OLIMEX/RP2350pc/(threads)

Thread 2 (2025-07-01):

Audio codec is "MONO", not "Stereo"

ericfont, 2025-07-01:
The [product page](https://www.olimex.com/Products/RaspberryPi/PICO/RP2350pc/open-source-hardware) and [readme](https://github.com/OLIMEX/RP2350pc/blob/main/README.md) incorrectly says "Stereo Audio codec", but the schematic has ES8311, which is a mono in and mono out codec chip. Although the codec has differential output, and although the output plus goes to the left headphone and amp while the output minus goes to the right headphone and amp, the left and right outputs would simply be the same audio signal of opposite polarities, so that output still is technically just "MONO", not "Stereo"!  Please correct the product page and readme's description.
