OLIMEX/RP2350pc/HARDWARE/RP2350pc-Rev.A/RP2350pc_Rev_A.kicad_sch

## KiCad design HARDWARE/RP2350pc-Rev.A/RP2350pc_Rev_A.kicad_sch (2025-06-16)

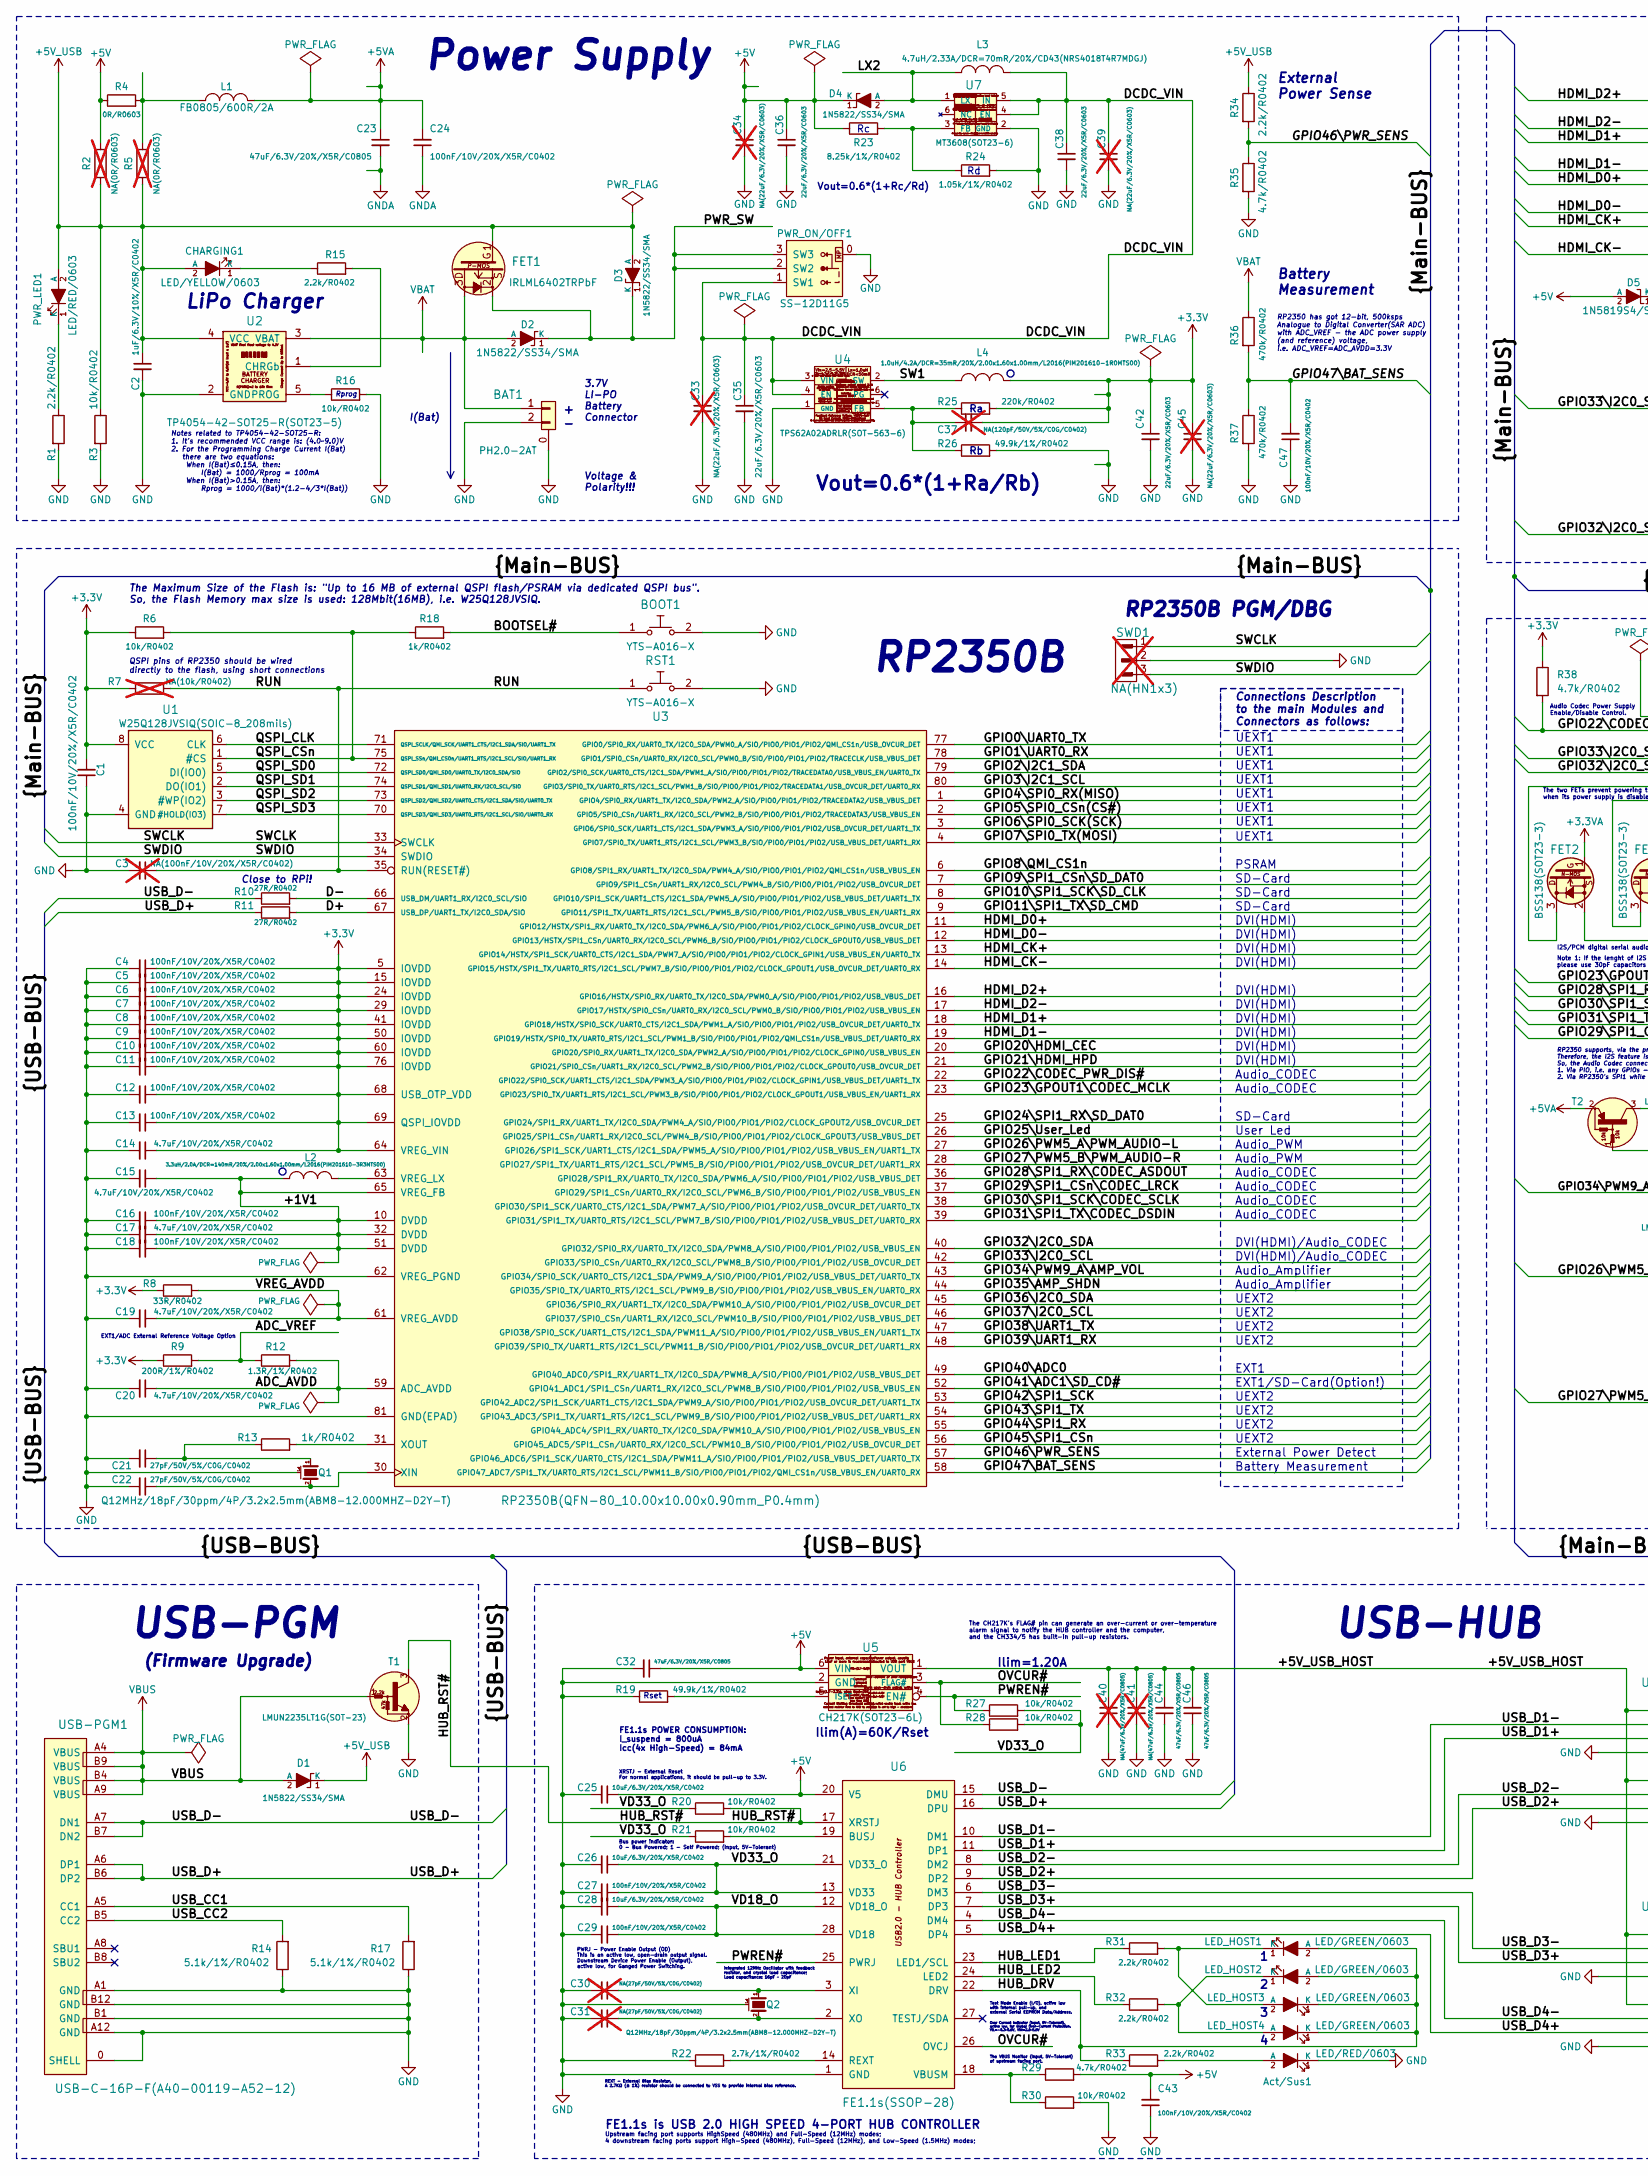
[picture p2: schematic RP2350pc_Rev_A.kicad_sch, part in row 1, column 1]

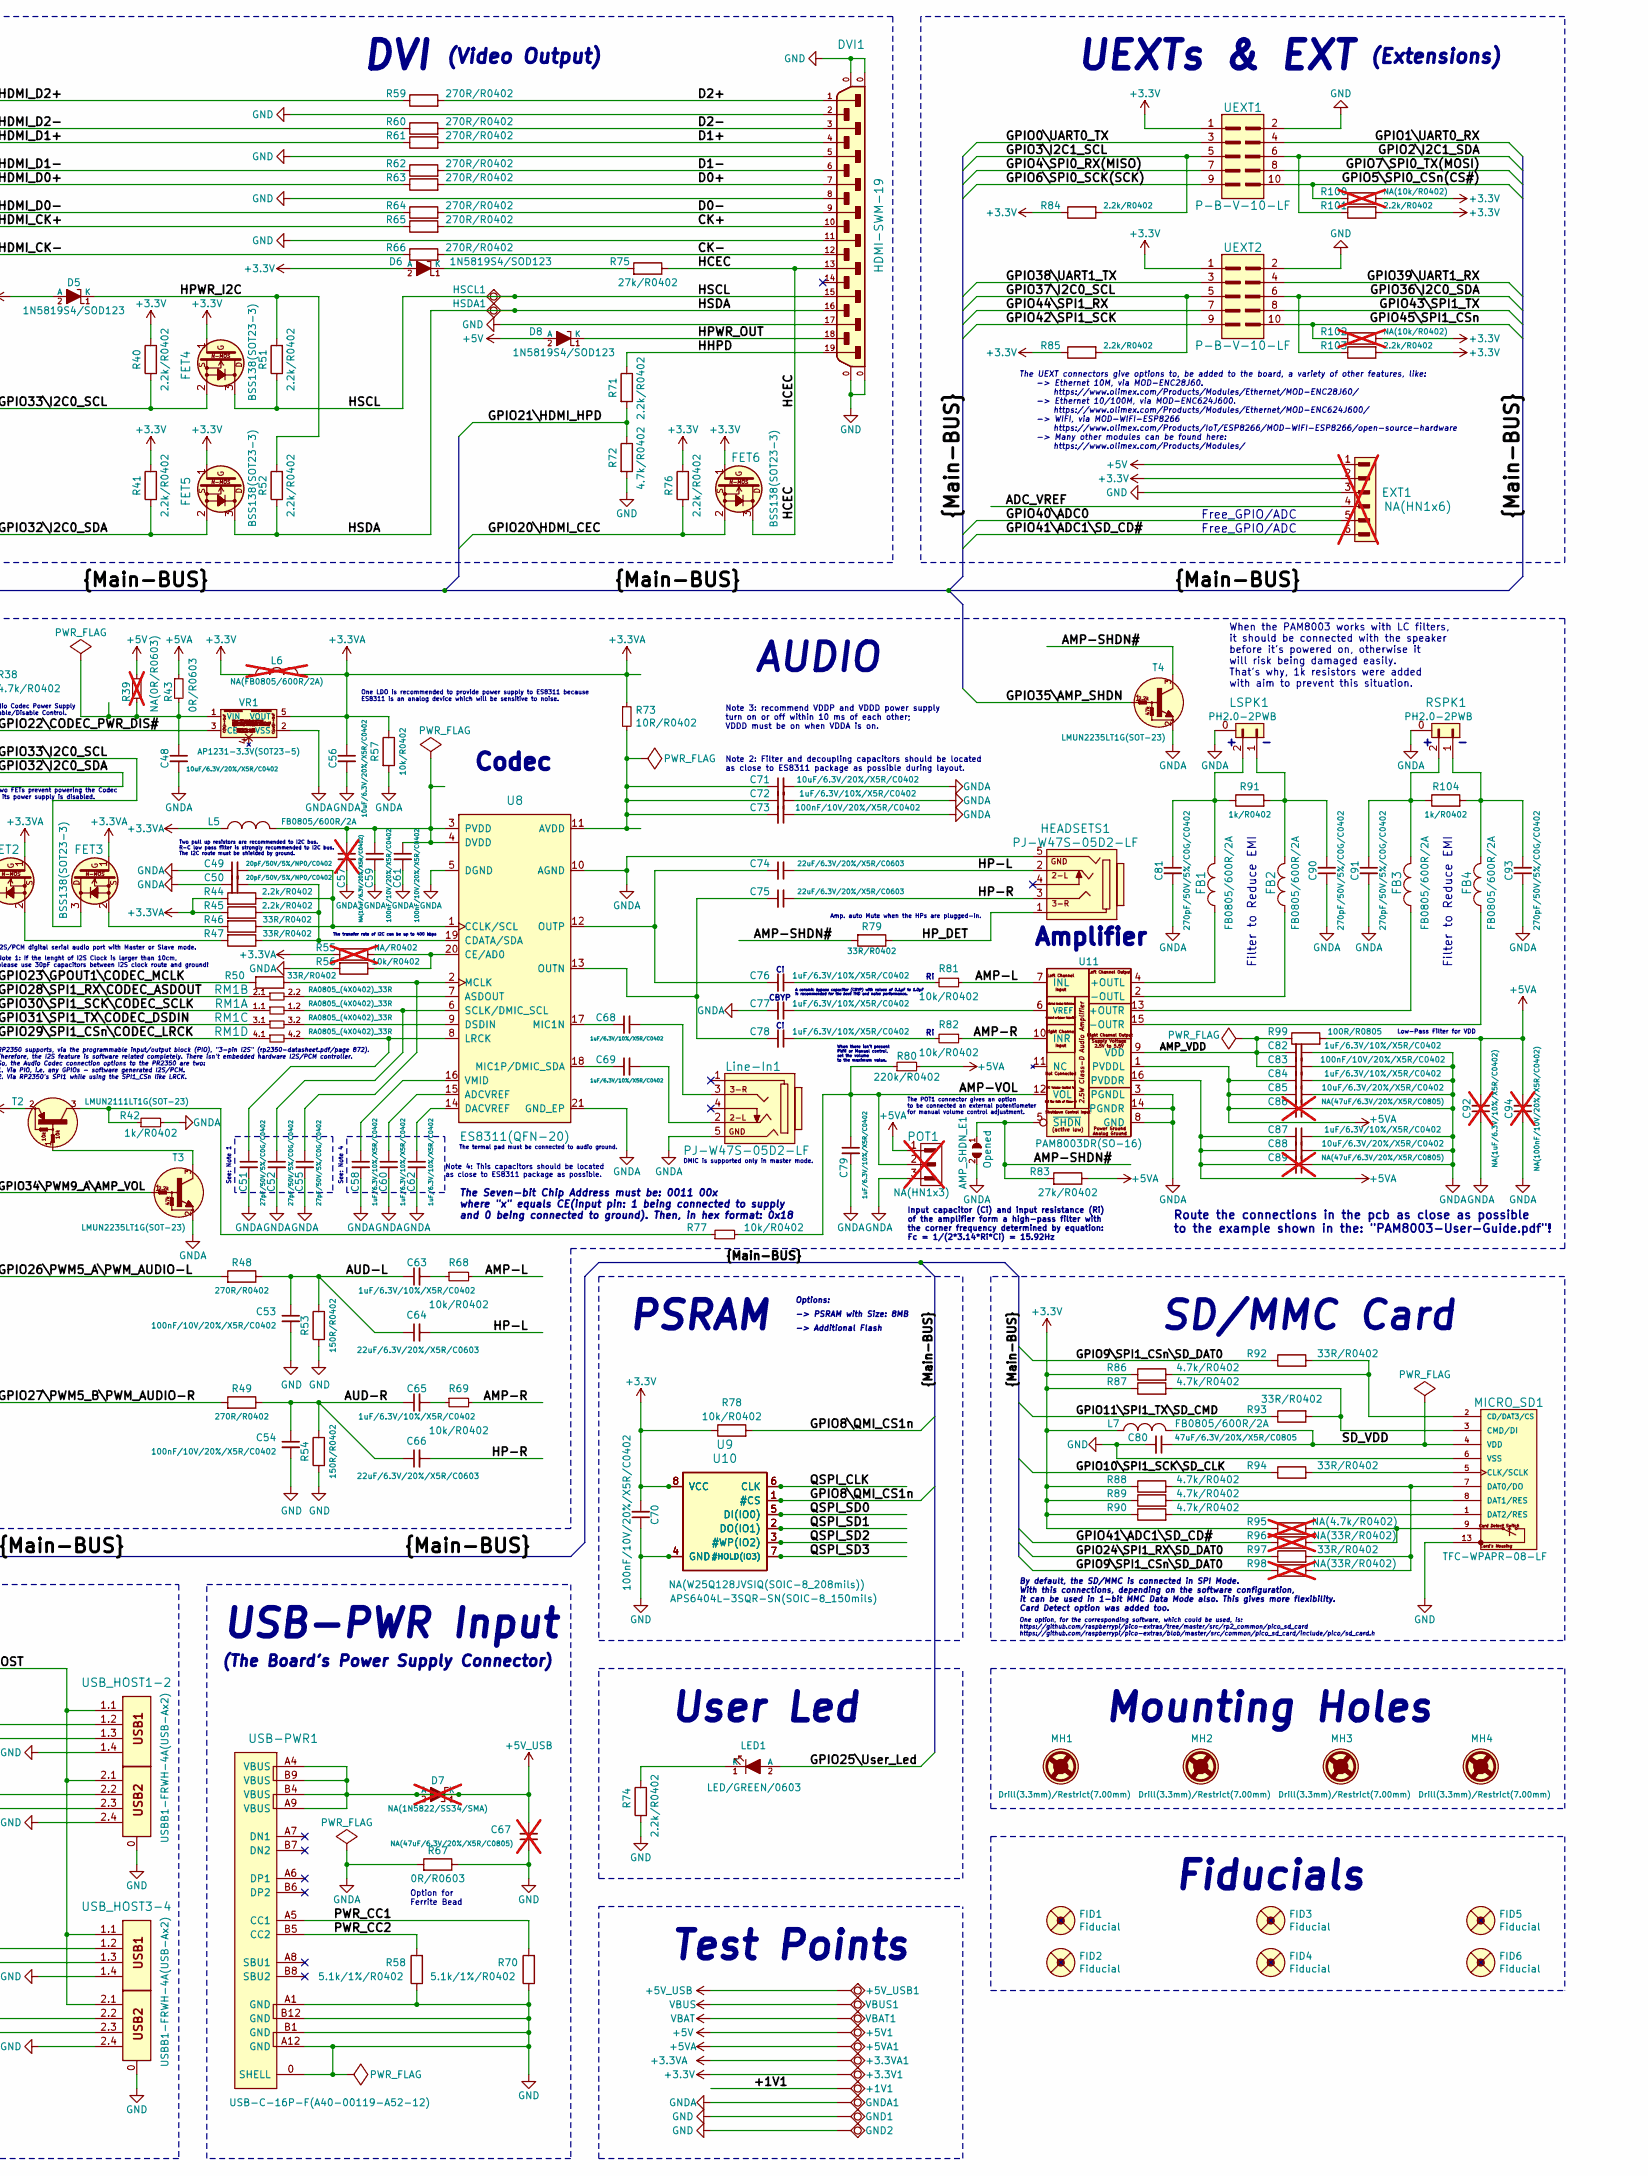
[picture p3: schematic RP2350pc_Rev_A.kicad_sch, part in row 1, column 2]

Parts:
+1V1, +3.3V1, +3.3VA1, +5V1, +5VA1, +5V_USB1: TESTPAD; TESTPAD_40-ROUND
AMP_SHDN_E1: Opened; SJ
Act/Sus1: LED/RED/0603; LED_0603_KA
BAT1: PH2.0-2AT; PH2.0-2AT(BAT)
BOOT1: YTS-A016-X
C1, C4, C5, C6, C7, C8, C9, C10, C11, C12, C13, C16, C18, C24, C27, C29, C43, C47, C53, C54, C59, C61, C70, C73, C83: 100nF/10V/20%/X5R/C0402; C_0402_5MIL_DWS
C2, C58, C60, C62, C63, C65, C68, C69, C72, C76, C77, C78, C79, C82, C84, C87: 1uF/6.3V/10%/X5R/C0402; C_0402_5MIL_DWS
C3, C94: NA(100nF/10V/20%/X5R/C0402); C_0402_5MIL_DWS; not fitted
C14, C15, C17, C19, C20: 4.7uF/10V/20%/X5R/C0402; C_0402_5MIL_DWS
C21, C22, C51, C52, C55: 27pF/50V/5%/C0G/C0402; C_0402_5MIL_DWS
C23, C32, C44, C46, C80: 47uF/6.3V/20%/X5R/C0805; C_0805_5MIL_DWS
C25, C26, C28, C48, C56, C71, C85, C88: 10uF/6.3V/20%/X5R/C0402; C_0402_5MIL_DWS
C30, C31: NA(27pF/50V/5%/C0G/C0402); C_0402_5MIL_DWS; not fitted
C33, C34, C39, C45: NA(22uF/6.3V/20%/X5R/C0603); C_0603_5MIL_DWS; not fitted
C35, C36, C38, C42, C64, C66, C74, C75: 22uF/6.3V/20%/X5R/C0603; C_0603_5MIL_DWS
C37: NA(120pF/50V/5%/C0G/C0402); C_0402_5MIL_DWS; not fitted
C40, C41, C67, C86, C89: NA(47uF/6.3V/20%/X5R/C0805); C_0805_5MIL_DWS; not fitted
C49, C50: 20pF/50V/5%/NP0/C0402; C_0402_5MIL_DWS
C57: NA(10uF/6.3V/20%/X5R/C0402); C_0402_5MIL_DWS; not fitted
C81, C90, C91, C93: 270pF/50V/5%/C0G/C0402; C_0402_5MIL_DWS
C92: NA(1uF/6.3V/10%/X5R/C0402); C_0402_5MIL_DWS; not fitted
CHARGING1: LED/YELLOW/0603; LED_0603_KA
D1, D2, D3, D4: 1N5822/SS34/SMA; SMA-KA
D5, D6, D8: 1N5819S4/SOD123; SOD-123_1C-2A_KA
D7: NA(1N5822/SS34/SMA); SMA-KA; not fitted
DVI1: HDMI-SWM-19; HDMI-SWM-19_Paste
EXT1: NA(HN1x6); HN1x6; not fitted
FB1, FB2, FB3, FB4: FB0805/600R/2A; L_0805_5MIL_DWS
FET1: IRLML6402TRPbF; SOT23
FET2, FET3, FET4, FET5, FET6: BSS138(SOT23-3); SOT23
FID1, FID2, FID3: Fiducial; Fiducial1x3_Paste
FID4, FID5, FID6: Fiducial; Fiducial1x3
GND1: TESTPAD; TEST_PAD40x70_SQUARE
GND2: TESTPAD; TESTPAD_40-ROUND
GNDA1: TESTPAD; TESTPAD_40-ROUND
HEADSETS1: PJ-W47S-05D2-LF; PJ-W47S-05D2-LF_5PIN_V2_LongerPads
HSCL1: TESTPAD; TESTPAD_40-ROUND
HSDA1: TESTPAD; TESTPAD_40-ROUND
L1, L5, L7: FB0805/600R/2A; L_0805_5MIL_DWS
L2: 3.3uH/2.0A/DCR=140mR/20%/2.00x1.60x1.00mm/L2016(P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; L_2016_MM
L3: 4.7uH/2.33A/DCR=70mR/20%/CD43(NRS4018T4R7MDGJ); CD42(43)
L4: 1.0uH/4.2A/DCR=35mR/20%/2.00x1.60x1.00mm/L2016(PI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; L_2016_MM
L6: NA(FB0805/600R/2A); L_0805_5MIL_DWS; not fitted
LED1: LED/GREEN/0603; LED_0603_KA
LED_HOST1, LED_HOST2, LED_HOST3, LED_HOST4: LED/GREEN/0603; LED_0603_KA
LSPK1: PH2.0-2PWB
Line-In1: PJ-W47S-05D2-LF; PJ-W47S-05D2-LF_5PIN_V2_LongerPads
MH1, MH2, MH3, MH4: Drill(3.3mm)/Restrict(7.00mm); Mounting_Hole_Drill-3.3mm_Clerance-7mm
MICRO_SD1: TFC-WPAPR-08-LF; TFC-WPAPR-08
POT1: NA(HN1x3); HN1x3; not fitted
PWR_LED1: LED/RED/0603; LED_0603_KA
PWR_ON/OFF1: SS-12D11G5
Q1, Q2: Q12MHz/18pF/30ppm/4P/3.2x2.5mm(ABM8-12.000MHZ-D2Y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; TSX-3.2x2.5mm_GND(3)
R1, R15, R31, R32, R33, R34, R40, R41, R44, R45, R51, R52, R71, R74, R76, R84, R85, R101, R103: 2.2k/R0402; R_0402_5MIL_DWS
R2, R5, R39: NA(0R/R0603); R_0603_5MIL_DWS; not fitted
R3, R6, R16, R20, R21, R27, R28, R30, R56, R57, R68, R69, R77, R78, R81, R82: 10k/R0402; R_0402_5MIL_DWS
R4, R43, R67: 0R/R0603; R_0603_5MIL_DWS
R7, R100, R102: NA(10k/R0402); R_0402_5MIL_DWS; not fitted
R8, R46, R47, R50, R79, R92, R93, R94, R97: 33R/R0402; R_0402_5MIL_DWS
R9: 200R/1%/R0402; R_0402_5MIL_DWS
R10, R11: 27R/R0402; R_0402_5MIL_DWS
R12: 1.3R/1%/R0402; R_0402_5MIL_DWS
R13, R18, R42, R91, R104: 1k/R0402; R_0402_5MIL_DWS
R14, R17, R58, R70: 5.1k/1%/R0402; R_0402_5MIL_DWS
R19, R26: 49.9k/1%/R0402; R_0402_5MIL_DWS
R22: 2.7k/1%/R0402; R_0402_5MIL_DWS
R23: 8.25k/1%/R0402; R_0402_5MIL_DWS
R24: 1.05k/1%/R0402; R_0402_5MIL_DWS
R25, R80: 220k/R0402; R_0402_5MIL_DWS
R29, R35, R38, R72, R86, R87, R88, R89, R90: 4.7k/R0402; R_0402_5MIL_DWS
R36, R37: 470k/R0402; R_0402_5MIL_DWS
R48, R49, R59, R60, R61, R62, R63, R64, R65, R66: 270R/R0402; R_0402_5MIL_DWS
R53, R54: 150R/R0402; R_0402_5MIL_DWS
R55: NA/R0402; R_0402_5MIL_DWS; not fitted
R73: 10R/R0402; R_0402_5MIL_DWS
R75, R83: 27k/R0402; R_0402_5MIL_DWS
R95: NA(4.7k/R0402); R_0402_5MIL_DWS; not fitted
R96, R98: NA(33R/R0402); R_0402_5MIL_DWS; not fitted
R99: 100R/R0805; R_0805_5MIL_DWS
RM1: RA0805_(4X0402)_33R; RA0805_(4X0402)_xx_BIGGEROUTPADS
RSPK1: PH2.0-2PWB
RST1: YTS-A016-X
SWD1: NA(HN1x3); HN1x3; not fitted
T1, T3, T4: LMUN2235LT1G(SOT-23); SOT23
T2: LMUN2111LT1G(SOT-23); SOT23
U1: W25Q128JVSIQ(SOIC-8_208mils); SO-8_208mil
U2: TP4054-42-SOT25-R(SOT23-5); SOT-23-5
U3: RP2350B(QFN-80_10.00x10.00x0.90mm_P0.4mm); QFN-80_10.00x10.00x0.90mm_P0.4mm
U4: TPS62A02ADRLR(SOT-563-6); SOT-563-6
U5: CH217K(SOT23-6L); SOT23-6
U6: FE1.1s(SSOP-28); SSOP28_10x4mm_Pitch_0.64mm
U7: MT3608(SOT23-6); SOT23-6
U8: ES8311(QFN-20); QFN-20_EP(21)_3x3x0.6mm_Pitch_0.4mm
U9: NA(W25Q128JVSIQ(SOIC-8_208mils)); SO-8_208mil
U10: APS6404L-3SQR-SN(SOIC-8_150mils); SO-8
U11: PAM8003DR(SO-16); SO-16
UEXT1, UEXT2: P-B-V-10-LF; GBH-254-SMT-10
USB-PGM1: USB-C-16P-F(A40-00119-A52-12); USB2.0_TYPE-C(A40-00119-A52-12)_Paste
USB-PWR1: USB-C-16P-F(A40-00119-A52-12); USB2.0_TYPE-C(A40-00119-A52-12)_Paste
USB_HOST1-2, USB_HOST3-4: USBB1-FRWH-4A(USB-Ax2); USB_TWO_LEVEL
VBAT1: TESTPAD; TESTPAD_40-ROUND
VBUS1: TESTPAD; TESTPAD_40-ROUND
VR1: AP1231-3.3V(SOT23-5); SOT-23-5

Connections:
+1V1: +1V1.1, C15.1, C16.1, C17.1, C18.1, L2.1, U3.10 (DVDD), U3.32 (DVDD), U3.51 (DVDD), U3.65 (VREG_FB)
+3.3V: +3.3V1.1, C1.2, C4.1, C5.1, C6.1, C7.1, C8.1, C9.1, C10.1, C11.1, C12.1, C13.1, C14.1, C37.2, C42.1, C45.1, C70.2, D6.2 (A), EXT1.2, FET4.1 (G), FET5.1 (G), FET6.1 (G), L4.1, L6.1, L7.1, R6.1, R7.1, R8.1, R9.1, R25.2, R38.1, R40.1, R41.1, R76.1, R78.1, R84.1, R85.1, R86.1, R87.1, R88.1, R89.1, R90.1, R95.1, R100.2, R101.2, R102.2, R103.2, U1.8 (VCC), U3.5 (IOVDD), U3.15 (IOVDD), U3.24 (IOVDD), U3.29 (IOVDD), U3.41 (IOVDD), U3.50 (IOVDD), U3.60 (IOVDD), U3.64 (VREG_VIN), U3.68 (USB_OTP_VDD), U3.69 (QSPI_IOVDD), U3.76 (IOVDD), U9.8 (VCC), U10.8 (VCC), UEXT1.1, UEXT2.1
+3.3VA: +3.3VA1.1, C56.1, FET2.1 (G), FET3.1 (G), L5.1, L6.2, R44.2, R45.2, R55.2, R57.1, R73.1, VR1.5 (VOUT)
+5V: +5V1.1, C25.1, C32.1, C34.1, C36.1, C43.2, D4.1 (K), D5.2 (A), D8.2 (A), EXT1.1, R2.2, R4.1, R23.1, R29.2, R39.1, U5.6 (VIN), U6.20 (V5)
+5VA: +5VA1.1, C23.1, C24.2, C84.2, C85.1, C86.2, C87.2, C88.1, C89.2, C92.2, C94.2, L1.2, POT1.1, R43.1, R80.2, R83.1, R99.2, T2.2 (E), U11.1 (PVDDL), U11.16 (PVDDR)
+5V_USB: +5V_USB1.1, C2.1, C67.2, CHARGING1.2 (A), D1.1 (K), D3.2 (A), D7.1 (K), D7.2 (A), FET1.1, PWR_LED1.2 (A), R2.1, R3.1, R5.1, R34.1, U2.4 (VCC), USB-PWR1.A4 (VBUS), USB-PWR1.A9 (VBUS), USB-PWR1.B4 (VBUS), USB-PWR1.B9 (VBUS)
+5V_USB_HOST: C40.2, C41.2, C44.2, C46.2, U5.1 (VOUT), USB_HOST1-2.1.1, USB_HOST1-2.2.1, USB_HOST3-4.1.1, USB_HOST3-4.2.1
ADC_AVDD: C20.1, R12.2, U3.59 (ADC_AVDD)
ADC_VREF: EXT1.4, R9.2, R12.1
AMP-L: R68.2, R81.1, U11.7 (INL)
AMP-R: R69.2, R82.1, U11.10 (INR)
AMP-SHDN#: AMP_SHDN_E1.1, R79.2, R83.2, T4.3 (C), U11.5 (~SHDN)
AMP-VOL: C79.1, POT1.2, R77.2, R80.1, U11.12 (VOL)
AMP_VDD: C82.2, C83.2, R99.1, U11.9 (VDD)
AUD-L: C53.1, C63.1, C64.1, R48.1, R53.1
AUD-R: C54.1, C65.1, C66.1, R49.1, R54.1
BOOTSEL#: BOOT1.1, R18.2
CK+: DVI1.10, R65.2
CK-: DVI1.12, R66.2
D0+: DVI1.7, R63.2
D0-: DVI1.9, R64.2
D1+: DVI1.4, R61.2
D1-: DVI1.6, R62.2
D2+: DVI1.1, R59.2
D2-: DVI1.3, R60.2
D+: R11.2, U3.67 (USB_DP/UART1_TX/I2C0_SDA/SIO)
D-: R10.2, U3.66 (USB_DM/UART1_RX/I2C0_SCL/SIO)
DCDC_VIN: C33.1, C35.1, C38.1, C39.1, L3.2, PWR_ON/OFF1.1 (SW1), U4.3 (VIN), U4.4 (EN), U7.4 (EN), U7.5 (IN)
GND: Act/Sus1.1 (K), BAT1.0, BAT1.2, BOOT1.2, C1.1, C2.2, C3.2, C4.2, C5.2, C6.2, C7.2, C8.2, C9.2, C10.2, C11.2, C12.2, C13.2, C14.2, C15.2, C16.2, C17.2, C18.2, C19.2, C20.2, C21.2, C22.2, C25.2, C26.2, C27.2, C28.2, C29.2, C30.2, C31.2, C32.2, C33.2, C34.2, C35.2, C36.2, C38.2, C39.2, C40.1, C41.1, C42.2, C43.1, C44.1, C45.2, C46.1, C47.1, C53.2, C54.2, C67.1, C70.1, C80.2, DVI1.0 (20), DVI1.2, DVI1.5, DVI1.8, DVI1.11, DVI1.17, EXT1.3, GND1.1, GND2.1, MICRO_SD1.6 (VSS), MICRO_SD1.10, MICRO_SD1.11, MICRO_SD1.12, MICRO_SD1.13, PWR_ON/OFF1.0, Q1.3 (case), Q2.3 (case), R1.2, R3.2, R14.1, R16.2, R17.1, R19.1, R22.1, R24.2, R26.2, R30.2, R35.2, R37.2, R53.2, R54.2, R58.1, R67.1, R70.1, R72.2, R74.2, RST1.2, SWD1.2, T1.2 (E), U1.4 (GND), U2.2 (GND), U3.62 (VREG_PGND), U3.81 (GND(EPAD)), U4.1 (GND), U5.2 (GND), U6.1 (GND), U7.2 (GND), U9.4 (GND), U10.4 (GND), UEXT1.2, UEXT2.2, USB-PGM1.0 (SHELL), USB-PGM1.A1 (GND), USB-PGM1.A12 (GND), USB-PGM1.B1 (GND), USB-PGM1.B12 (GND), USB-PWR1.0 (SHELL), USB-PWR1.A1 (GND), USB-PWR1.A12 (GND), USB-PWR1.B1 (GND), USB-PWR1.B12 (GND), USB_HOST1-2.0, USB_HOST1-2.1.4, USB_HOST1-2.2.4, USB_HOST3-4.0, USB_HOST3-4.1.4, USB_HOST3-4.2.4
GNDA: AMP_SHDN_E1.2, C23.2, C24.1, C48.2, C49.2, C50.2, C51.2, C52.2, C55.2, C56.2, C57.2, C58.2, C59.2, C60.2, C61.2, C62.2, C71.2, C72.2, C73.1, C77.2, C79.2, C81.2, C82.1, C83.1, C84.1, C85.2, C86.1, C87.1, C88.2, C89.1, C90.1, C91.2, C92.1, C93.1, C94.1, GNDA1.1, HEADSETS1.5, LSPK1.0, Line-In1.5, POT1.3, R42.2, R56.2, R57.2, R67.2, RSPK1.0, T3.2 (E), T4.2 (E), U8.5 (DGND), U8.10 (AGND), U8.21 (GND_EP), U11.3 (PGNDL), U11.8 (GND), U11.14 (PGNDR), VR1.2 (VSS)
GPIO0\UART0_TX: U3.77 (GPIO0/SPI0_RX/UART0_TX/I2C0_SDA/PWM0_A/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), UEXT1.3
GPIO1\UART0_RX: U3.78 (GPIO1/SPI0_CSn/UART0_RX/I2C0_SCL/PWM0_B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), UEXT1.4
GPIO2\I2C1_SDA: R101.1, U3.79 (GPIO2/SPI0_SCK/UART0_CTS/I2C1_SDA/PWM1_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), UEXT1.6
GPIO3\I2C1_SCL: R84.2, U3.80 (GPIO3/SPI0_TX/UART0_RTS/I2C1_SCL/PWM1_B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), UEXT1.5
GPIO4\SPI0_RX(MISO): U3.1 (GPIO4/SPI0_RX/UART1_TX/I2C0_SDA/PWM2_A/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), UEXT1.7
GPIO5\SPI0_CSn(CS#): R100.1, U3.2 (GPIO5/SPI0_CSn/UART1_RX/I2C0_SCL/PWM2_B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), UEXT1.10
GPIO6\SPI0_SCK(SCK): U3.3 (GPIO6/SPI0_SCK/UART1_CTS/I2C1_SDA/PWM3_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), UEXT1.9
GPIO7\SPI0_TX(MOSI): U3.4 (GPIO7/SPI0_TX/UART1_RTS/I2C1_SCL/PWM3_B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), UEXT1.8
GPIO8\QMI_CS1n: R78.2, U3.6 (GPIO8/SPI1_RX/UART1_TX/I2C0_SDA/PWM4_A/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), U9.1 (#CS), U10.1 (#CS)
GPIO9\SPI1_CSn\SD_DAT0: R92.1, R98.1, U3.7 (GPIO9/SPI1_CSn/UART1_RX/I2C0_SCL/PWM4_B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)
GPIO10\SPI1_SCK\SD_CLK: R94.1, U3.8 (GPIO10/SPI1_SCK/UART1_CTS/I2C1_SDA/PWM5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)
GPIO11\SPI1_TX\SD_CMD: R93.1, U3.9 (GPIO11/SPI1_TX/UART1_RTS/I2C1_SCL/PWM5_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)
GPIO20\HDMI_CEC: FET6.2 (S), R76.2, U3.20 (GPIO20/SPI0_RX/UART1_TX/I2C0_SDA/PWM2_A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)
GPIO21\HDMI_HPD: R71.2, R72.1, U3.21 (GPIO21/SPI0_CSn/UART1_RX/I2C0_SCL/PWM2_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)
GPIO22\CODEC_PWR_DIS#: R38.2, U3.22 (GPIO22/SPI0_SCK/UART1_CTS/I2C1_SDA/PWM3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), VR1.3 (CE)
GPIO23\GPOUT1\CODEC_MCLK: R50.2, U3.23 (GPIO23/SPI0_TX/UART1_RTS/I2C1_SCL/PWM3_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)
GPIO24\SPI1_RX\SD_DAT0: R97.1, U3.25 (GPIO24/SPI1_RX/UART1_TX/I2C0_SDA/PWM4_A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)
GPIO25\User_Led: LED1.2 (A), U3.26 (GPIO25/SPI1_CSn/UART1_RX/I2C0_SCL/PWM4_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)
GPIO26\PWM5_A\PWM_AUDIO-L: R48.2, U3.27 (GPIO26/SPI1_SCK/UART1_CTS/I2C1_SDA/PWM5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)
GPIO27\PWM5_B\PWM_AUDIO-R: R49.2, U3.28 (GPIO27/SPI1_TX/UART1_RTS/I2C1_SCL/PWM5_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)
GPIO28\SPI1_RX\CODEC_ASDOUT: RM1.2.1, U3.36 (GPIO28/SPI1_RX/UART0_TX/I2C0_SDA/PWM6_A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)
GPIO29\SPI1_CSn\CODEC_LRCK: RM1.4.1, U3.37 (GPIO29/SPI1_CSn/UART0_RX/I2C0_SCL/PWM6_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)
GPIO30\SPI1_SCK\CODEC_SCLK: RM1.1.1, U3.38 (GPIO30/SPI1_SCK/UART0_CTS/I2C1_SDA/PWM7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)
GPIO31\SPI1_TX\CODEC_DSDIN: RM1.3.1, U3.39 (GPIO31/SPI1_TX/UART0_RTS/I2C1_SCL/PWM7_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)
GPIO32\I2C0_SDA: FET2.3 (D), FET5.2 (S), R41.2, U3.40 (GPIO32/SPI0_RX/UART0_TX/I2C0_SDA/PWM8_A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)
GPIO33\I2C0_SCL: FET3.3 (D), FET4.2 (S), R40.2, U3.42 (GPIO33/SPI0_CSn/UART0_RX/I2C0_SCL/PWM8_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)
GPIO34\PWM9_A\AMP_VOL: T3.1 (B), U3.43 (GPIO34/SPI0_SCK/UART0_CTS/I2C1_SDA/PWM9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)
GPIO35\AMP_SHDN: T4.1 (B), U3.44 (GPIO35/SPI0_TX/UART0_RTS/I2C1_SCL/PWM9_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)
GPIO36\I2C0_SDA: R103.1, U3.45 (GPIO36/SPI0_RX/UART1_TX/I2C0_SDA/PWM10_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), UEXT2.6
GPIO37\I2C0_SCL: R85.2, U3.46 (GPIO37/SPI0_CSn/UART1_RX/I2C0_SCL/PWM10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), UEXT2.5
GPIO38\UART1_TX: U3.47 (GPIO38/SPI0_SCK/UART1_CTS/I2C1_SDA/PWM1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), UEXT2.3
GPIO39\UART1_RX: U3.48 (GPIO39/SPI0_TX/UART1_RTS/I2C1_SCL/PWM11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), UEXT2.4
GPIO40\ADC0: EXT1.5, U3.49 (GPIO40_ADC0/SPI1_RX/UART1_TX/I2C0_SDA/P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)
GPIO41\ADC1\SD_CD#: EXT1.6, R96.1, U3.52 (GPIO41_ADC1/SPI1_CSn/UART1_RX/I2C0_SCL/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)
GPIO42\SPI1_SCK: U3.53 (GPIO42_ADC2/SPI1_SCK/UART1_CTS/I2C1_SDA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), UEXT2.9
GPIO43\SPI1_TX: U3.54 (GPIO43_ADC3/SPI1_TX/UART1_RTS/I2C1_SCL/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), UEXT2.8
GPIO44\SPI1_RX: U3.55 (GPIO44_ADC4/SPI1_RX/UART0_TX/I2C0_SDA/P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), UEXT2.7
GPIO45\SPI1_CSn: R102.1, U3.56 (GPIO45_ADC5/SPI1_CSn/UART0_RX/I2C0_SCL/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), UEXT2.10
GPIO46\PWR_SENS: R34.2, R35.1, U3.57 (GPIO46_ADC6/SPI1_SCK/UART0_CTS/I2C1_SDA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)
GPIO47\BAT_SENS: C47.2, R36.2, R37.1, U3.58 (GPIO47_ADC7/SPI1_TX/UART0_RTS/I2C1_SCL/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)
HCEC: DVI1.13, FET6.3 (D), R75.1
HDMI_CK+: R65.1, U3.13 (GPIO14/HSTX/SPI1_SCK/UART0_CTS/I2C1_SDA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)
HDMI_CK-: R66.1, U3.14 (GPIO15/HSTX/SPI1_TX/UART0_RTS/I2C1_SCL/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)
HDMI_D0+: R63.1, U3.11 (GPIO12/HSTX/SPI1_RX/UART0_TX/I2C0_SDA/P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)
HDMI_D0-: R64.1, U3.12 (GPIO13/HSTX/SPI1_CSn/UART0_RX/I2C0_SCL/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)
HDMI_D1+: R61.1, U3.18 (GPIO18/HSTX/SPI0_SCK/UART0_CTS/I2C1_SDA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)
HDMI_D1-: R62.1, U3.19 (GPIO19/HSTX/SPI0_TX/UART0_RTS/I2C1_SCL/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)
HDMI_D2+: R59.1, U3.16 (GPIO16/HSTX/SPI0_RX/UART0_TX/I2C0_SDA/P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)
HDMI_D2-: R60.1, U3.17 (GPIO17/HSTX/SPI0_CSn/UART0_RX/I2C0_SCL/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)
HHPD: DVI1.19, R71.1
HP-L: C64.2, C74.1, HEADSETS1.2
HP-R: C66.2, C75.1, HEADSETS1.3
HPWR_I2C: D5.1 (K), R51.2, R52.2
HPWR_OUT: D8.1 (K), DVI1.18
HP_DET: HEADSETS1.1, R79.1
HSCL: DVI1.15, FET4.3 (D), HSCL1.1, R51.1
HSDA: DVI1.16, FET5.3 (D), HSDA1.1, R52.1
HUB_DRV: LED_HOST1.2 (A), LED_HOST2.2 (A), LED_HOST3.1 (K), LED_HOST4.1 (K), R33.1, U6.22 (DRV)
HUB_LED1: R31.1, U6.23 (LED1/SCL)
HUB_LED2: R32.1, U6.24 (LED2)
HUB_RST#: R20.2, T1.3 (C), U6.17 (XRSTJ)
LX2: D4.2 (A), L3.1, U7.1 (LX)
unnamed: Act/Sus1.2 (A), R33.2
unnamed: C21.1, Q1.1, R13.1
unnamed: C22.1, Q1.2, U3.30 (XIN)
unnamed: C30.1, Q2.1, U6.3 (XI)
unnamed: C31.1, Q2.2, U6.2 (XO)
unnamed: C37.1, R25.1, R26.1, U4.5 (FB)
unnamed: C48.1, R39.2, R43.2, VR1.1 (VIN)
unnamed: C49.1, R44.1, R46.1, U8.1 (CCLK/SCL)
unnamed: C50.1, R45.1, R47.1, U8.19 (CDATA/SDA)
unnamed: C51.1, RM1.4.2, U8.8 (LRCK)
unnamed: C52.1, RM1.1.2, U8.6 (SCLK/DMIC_SCL)
unnamed: C55.1, R50.1, U8.2 (MCLK)
unnamed: C57.1, C59.1, C61.1, L5.2, U8.3 (PVDD), U8.4 (DVDD)
unnamed: C58.1, U8.16 (VMID)
unnamed: C60.1, U8.15 (ADCVREF)
unnamed: C62.1, U8.14 (DACVREF)
unnamed: C63.2, R68.1
unnamed: C65.2, R69.1
unnamed: C68.1, Line-In1.3
unnamed: C68.2, U8.17 (MIC1N)
unnamed: C69.1, Line-In1.2
unnamed: C69.2, U8.18 (MIC1P/DMIC_SDA)
unnamed: C71.1, C72.1, C73.2, R73.2, U8.11 (AVDD)
unnamed: C74.2, C76.2, U8.12 (OUTP)
unnamed: C75.2, C78.2, U8.13 (OUTN)
unnamed: C76.1, R81.2
unnamed: C77.1, U11.6 (VREF)
unnamed: C78.1, R82.2
unnamed: C81.1, FB1.1, LSPK1.2, R91.1
unnamed: C90.2, FB2.1, LSPK1.1, R91.2
unnamed: C91.1, FB3.1, R104.1, RSPK1.2
unnamed: C93.2, FB4.1, R104.2, RSPK1.1
unnamed: CHARGING1.1 (K), R15.1
unnamed: D6.1 (K), R75.2
unnamed: FB1.2, U11.4 (+OUTL)
unnamed: FB2.2, U11.2 (-OUTL)
unnamed: FB3.2, U11.13 (+OUTR)
unnamed: FB4.2, U11.15 (-OUTR)
unnamed: FET2.2 (S), R47.2
unnamed: FET3.2 (S), R46.2
unnamed: L1.1, R4.2, R5.2
unnamed: L2.2, U3.63 (VREG_LX)
unnamed: LED1.1 (K), R74.1
unnamed: LED_HOST1.1 (K), LED_HOST3.2 (A), R31.2
unnamed: LED_HOST2.1 (K), LED_HOST4.2 (A), R32.2
unnamed: MICRO_SD1.1 (DAT2/RES), R90.2
unnamed: MICRO_SD1.2 (CD/DAT3/CS), R86.2, R92.2
unnamed: MICRO_SD1.3 (CMD/DI), R87.2, R93.2
unnamed: MICRO_SD1.5 (CLK/SCLK), R94.2
unnamed: MICRO_SD1.7 (DAT0/DO), R88.2, R97.2, R98.2
unnamed: MICRO_SD1.8 (DAT1/RES), R89.2
unnamed: MICRO_SD1.9, R95.2, R96.2
unnamed: PWR_LED1.1 (K), R1.1
unnamed: R13.2, U3.31 (XOUT)
unnamed: R15.2, U2.1 (CHRGb)
unnamed: R16.1, U2.5 (PROG)
unnamed: R19.2, U5.5 (ISET)
unnamed: R21.2, U6.19 (BUSJ)
unnamed: R22.2, U6.14 (REXT)
unnamed: R23.2, R24.1, U7.3 (FB)
unnamed: R29.1, R30.1, U6.18 (VBUSM)
unnamed: R42.1, R77.1, T2.3 (C)
unnamed: R55.1, R56.1, U8.20 (CE/AD0)
unnamed: RM1.2.2, U8.7 (ASDOUT)
unnamed: RM1.3.2, U8.9 (DSDIN)
unnamed: T2.1 (B), T3.3 (C)
OVCUR#: R28.1, U5.3 (FLAG#), U6.26 (OVCJ)
PWREN#: R27.1, U5.4 (EN#), U6.25 (PWRJ)
PWR_CC1: R70.2, USB-PWR1.A5 (CC1)
PWR_CC2: R58.2, USB-PWR1.B5 (CC2)
PWR_SW: D2.1 (K), D3.1 (K), FET1.2, PWR_ON/OFF1.2 (SW2), PWR_ON/OFF1.3 (SW3)
QSPI_CLK: U1.6 (CLK), U3.71 (QSPI_SCLK/QMI_SCK/UART1_CTS/I2C1_SDA/SI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), U9.6 (CLK), U10.6 (CLK)
QSPI_CSn: R6.2, R18.1, U1.1 (#CS), U3.75 (QSPI_SSn/QMI_CS0n/UART1_RTS/I2C1_SCL/SI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)
QSPI_SD0: U1.5 (DI(IO0)), U3.72 (QSPI_SD0/QMI_SD0/UART0_TX/I2C0_SDA/SIO), U9.5 (DI(IO0)), U10.5 (DI(IO0))
QSPI_SD1: U1.2 (DO(IO1)), U3.74 (QSPI_SD1/QMI_SD1/UART0_RX/I2C0_SCL/SIO), U9.2 (DO(IO1)), U10.2 (DO(IO1))
QSPI_SD2: U1.3 (#WP(IO2)), U3.73 (QSPI_SD2/QMI_SD2/UART0_CTS/I2C1_SDA/SIO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), U9.3 (#WP(IO2)), U10.3 (#WP(IO2))
QSPI_SD3: U1.7 (#HOLD(IO3)), U3.70 (QSPI_SD3/QMI_SD3/UART0_RTS/I2C1_SCL/SIO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), U9.7 (#HOLD(IO3)), U10.7 (#HOLD(IO3))
RUN: C3.1, R7.2, RST1.1, U3.35 (RUN(RESET#))
SD_VDD: C80.1, L7.2, MICRO_SD1.4 (VDD)
SW1: L4.2, U4.2 (SW)
SWCLK: SWD1.1, U3.33 (SWCLK)
SWDIO: SWD1.3, U3.34 (SWDIO)
USB_CC1: R17.2, USB-PGM1.A5 (CC1)
USB_CC2: R14.2, USB-PGM1.B5 (CC2)
USB_D1+: U6.11 (DP1), USB_HOST1-2.1.3
USB_D1-: U6.10 (DM1), USB_HOST1-2.1.2
USB_D2+: U6.9 (DP2), USB_HOST1-2.2.3
USB_D2-: U6.8 (DM2), USB_HOST1-2.2.2
USB_D3+: U6.7 (DP3), USB_HOST3-4.1.3
USB_D3-: U6.6 (DM3), USB_HOST3-4.1.2
USB_D4+: U6.5 (DP4), USB_HOST3-4.2.3
USB_D4-: U6.4 (DM4), USB_HOST3-4.2.2
USB_D+: R11.1, U6.16 (DPU), USB-PGM1.A6 (DP1), USB-PGM1.B6 (DP2)
USB_D-: R10.1, U6.15 (DMU), USB-PGM1.A7 (DN1), USB-PGM1.B7 (DN2)
VBAT: BAT1.1, D2.2 (A), FET1.3, R36.1, U2.3 (VBAT), VBAT1.1
VBUS: D1.2 (A), T1.1 (B), USB-PGM1.A4 (VBUS), USB-PGM1.A9 (VBUS), USB-PGM1.B4 (VBUS), USB-PGM1.B9 (VBUS), VBUS1.1
VD18_O: C28.1, C29.1, U6.12 (VD18_O), U6.28 (VD18)
VD33_O: C26.1, C27.1, R20.1, R21.1, R27.2, R28.2, U6.13 (VD33), U6.21 (VD33_O)
VREG_AVDD: C19.1, R8.2, U3.61 (VREG_AVDD)

Notes on the sheet:
Filter to Reduce EMI
UEXT1
Battery Measurement
Audio_CODEC
Bus power indicator: 0 - Bus Powered; 1 - Self Powered; (Input, 5V-Tolerant)
Battery Measurement
(Firmware Upgrade)
Vout=0.6*(1+Ra/Rb)
Ilim(A)=60K/Rset
Free_GPIO/ADC
Note 3: recommend VDDP and VDDD power supply turn on or off within 10 ms of each other; VDDD must be on when VDDA is on.
DVI(HDMI)
UEXT2
RP2350 has got 12-bit, 500ksps Analogue to Digital Converter(SAR ADC) with ADC_VREF - the ADC power supply (and reference) voltage, i.e. ADC_VREF=ADC_AVDD=3.3V
See: Note 4
QSPI pins of RP2350 should be wired directly to the flash, using short connections
When there isn't present PWM or Manual control, set the volume to the maximum value.
(Video Output)
(Extensions)
3.7V LI-PO Battery Connector
Upstream facing port supports HighSpeed (480MHz) and Full-Speed (12MHz) modes; 4 downstream facing ports support High-Speed (480MHz), Full-Speed (12MHz), and Low-Speed (1.5MHz) modes;
REXT - External Bias Resistor. A 2.7KΩ (± 1%) resistor should be connected to VSS to provide internal bias reference.
PSRAM
EXT1/ADC External Reference Voltage Option
See: Note 1
The UEXT connectors give options to, be added to the board, a variety of other features, like: -> Ethernet 10M, via MOD-ENC28J60. https://www.olimex.com/Products/Modules/Ethernet/MOD-ENC28J60/ -> Ethernet 10/100M, via MOD-ENC624J600. https://www.olimex.com/Products/Modules/Ethernet/MOD-ENC624J600/ 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
The transfer rate of I2C can be up to 400 kbps
USB-PGM
USB-HUB
The POT1 connector gives an option to be connected an external potentiometer for manual volume control adjustment.
SD-Card
The CH217K's FLAG# pin can generate an over-current or over-temperature alarm signal to notify the HUB controller and the computer, and the CH334/5 has built-in pull-up resistors.
Note 2: Filter and decoupling capacitors should be located as close to ES8311 package as possible during layout.
User Led
One LDO is recommended to provide power supply to ES8311 because ES8311 is an analog device which will be sensitive to noise.
The termal pad must be connected to audio ground.
Option for Ferrite Bead
-> Additional Flash
DVI(HDMI)/Audio_CODEC
The Seven-bit Chip Address must be: 0011 00x where "x" equals CE(input pin: 1 being connected to supply and 0 being connected to ground). Then, in hex format: 0x18
Vout=0.6*(1+Rc/Rd)
Note 4: This capacitors should be located as close to ES8311 package as possible.
AUDIO
I(Bat)
CBYP
EXT1
Integrated 12MHz Oscillator with feedback resistor, and crystal load capacitance; Load capacitance: 16pF ~ 20pF
PWRJ - Power Enable Output (OD) This is an active low, open-drain output signal. Downstream Device Power Enable (Output), active low, for Ganged Power Switching.
LiPo Charger
UEXTs & EXT
(The Board's Power Supply Connector)
Amp. auto Mute when the HPs are plugged-in.
Two pull up resistors are recommended to I2C bus. R-C low pass filter is strongly recommended to I2C bus. The I2C route must be shielded by ground.
XRSTJ - External Reset For normal applications, it should be pull-up to 3.3V.
Audio_PWM
Connections Description to the main Modules and Connectors as follows:
EXT1/SD-Card(Option!)
Notes related to TP4054-42-SOT25-R: 1. It's recommended VCC range is: (4.0~9.0)V 2. For the Programming Charge Current I(Bat) there are two equations: When I(Bat)≤0.15A, then: I(Bat) = 1000/Rprog = 100mA When I(Bat)>0.15A, then: Rprog = 1000/I(Bat)*(1.2-4/3*I(Bat))
Mounting Holes
External Power Detect
Low-Pass Filter for VDD
SD/MMC Card
Audio_Amplifier
The Maximum Size of the Flash is: "Up to 16 MB of external QSPI flash/PSRAM via dedicated QSPI bus". So, the Flash Memory max size is used: 128Mbit(16MB), i.e. W25Q128JVSIQ.
The VBUS Monitor (Input, 5V-Tolerant) of upstream facing port.
Route the connections in the pcb as close as possible to the example shown in the: "PAM8003-User-Guide.pdf"!
Fiducials
FE1.1s POWER CONSUMPTION: I_suspend = 800uA Icc(4x High-Speed) = 84mA
Power Supply
FE1.1s is USB 2.0 HIGH SPEED 4-PORT HUB CONTROLLER
Test Points
Note 1: If the lenght of I2S Clock is larger than 10cm, please use 30pF capacitors between I2S clock route and ground!
Amplifier
Input capacitor (Ci) and input resistance (Ri) of the amplifier form a high-pass filter with the corner frequency determined by equation: Fc = 1/(2*3.14*Ri*Ci) = 15.92Hz
Ilim=1.20A
Codec
RP2350B PGM/DBG
RP2350 supports, via the programmable input/output block (PIO), "3-pin I2S" (rp2350-datasheet.pdf/page 872). Therefore, the I2S feature is software related completely. There isn't embedded hardware I2S/PCM controller. So, the Audio Codec connection options to the PR2350 are two: 1. Via PIO, i.e. an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
When the PAM8003 works with LC filters, it should be connected with the speaker before it's powered on, otherwise it will risk being damaged easily. That's why, 1k resistors were added with aim to prevent this situation.
DMIC is supported only in master mode.
DVI
The two FETs prevent powering the Codec when its power supply is disabled.
A ceramic bypass capacitor (CBYP) with values of 0.1μF to 1.0μF is recommended for the best THD and noise performance.
Options:
Over Current Indicator (Input, 5V-Tolerant), active low, for Global Over-Current Protection. VIL=-0.3~0.8V, VIH=2.0~5.5V
USB-PWR Input
Voltage & Polarity!!!
Test Mode Enable (I/O), active low with internal pull-up, and external Serial EEPROM Data/Address.
External Power Sense
Rset
Rprog
RP2350B
I2S/PCM digital serial audio port with Master or Slave mode.
Audio Codec Power Supply Enable/Disable Control.
Close to RPi!
By default, the SD/MMC is connected in SPI Mode. With this connections, depending on the software configuration, it can be used in 1-bit MMC Data Mode also. This gives more flexibility. Card Detect option was added too.
-> PSRAM with Size: 8MB
One option, for the corresponding software, which could be used, is: https://github.com/raspberrypi/pico-extras/tree/master/src/rp2_common/pico_sd_card https://github.com/raspberrypi/pico-extras/blob/master/src/common/pico_sd_card/include/pico/sd_card.h
